featherfeet/6S092FinalProject/PhasedArrayReceiver/PDF_Plots/PhasedArrayReceiver-B_Cu.pdf

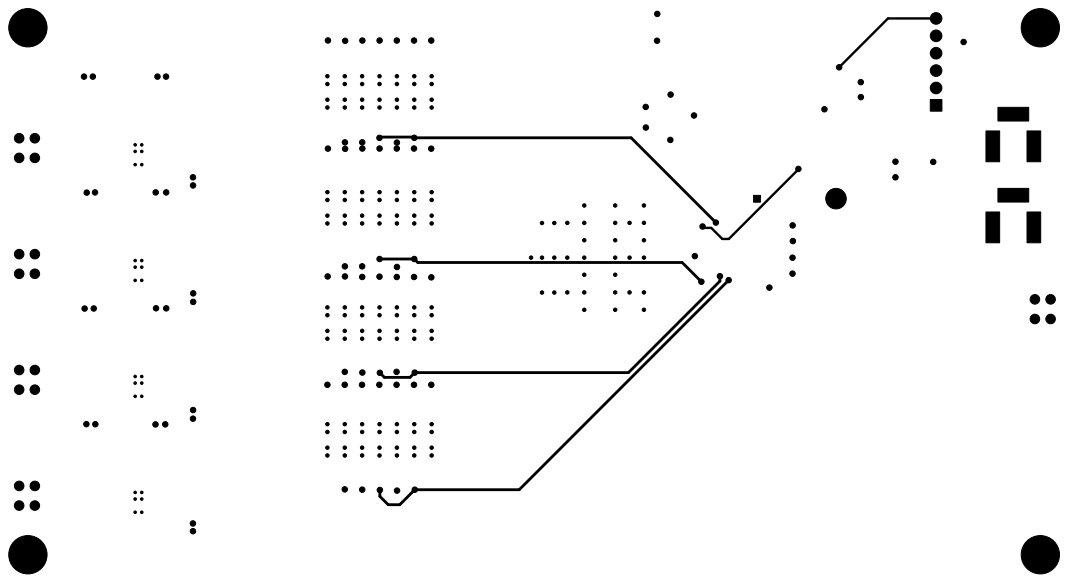
[picture p5: page 1]
