featherfeet/6S092FinalProject/PhasedArrayReceiver/PDF_Plots/PhasedArrayReceiver-B_Mask.pdf

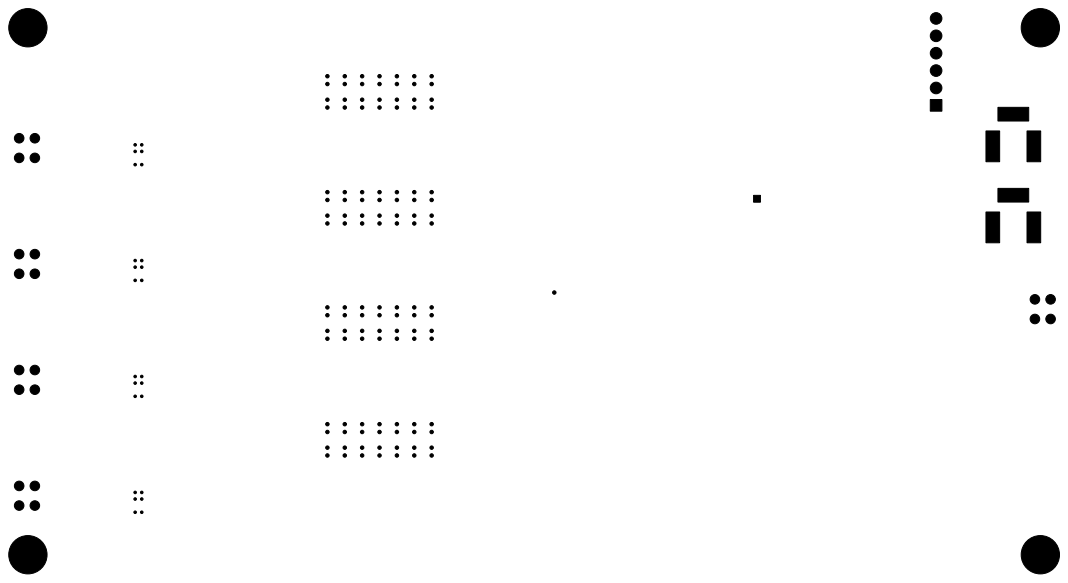
[picture p6: page 1]
