featherfeet/6S092FinalProject/PhasedArrayReceiver/PDF_Plots/PhasedArrayReceiver-Edge_Cuts.pdf

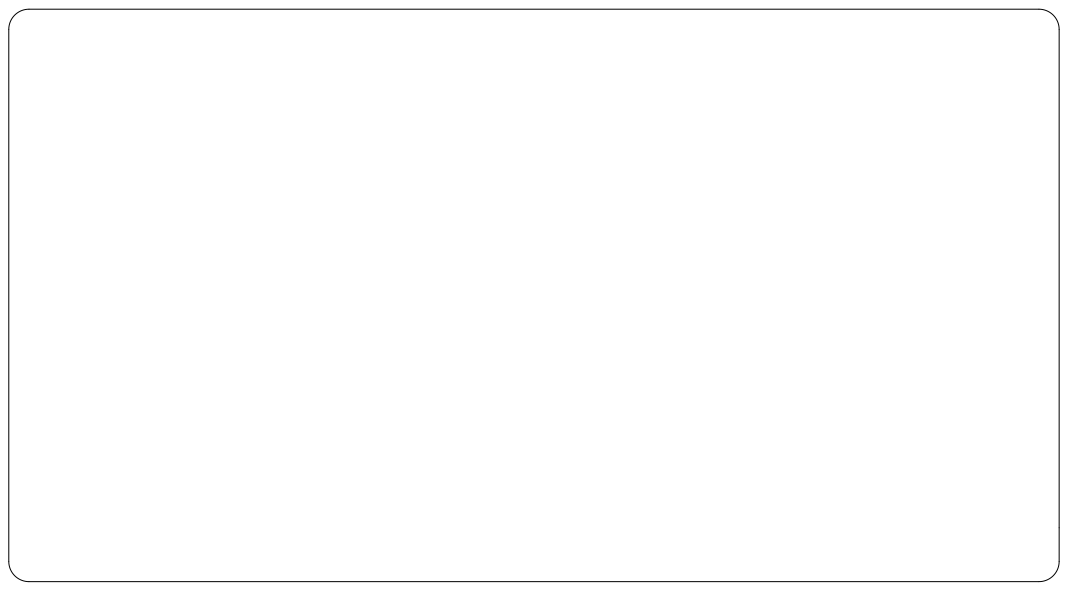
[picture p7: page 1]
