featherfeet/6S092FinalProject/PhasedArrayReceiver/PDF_Plots/PhasedArrayReceiver-F_Cu.pdf

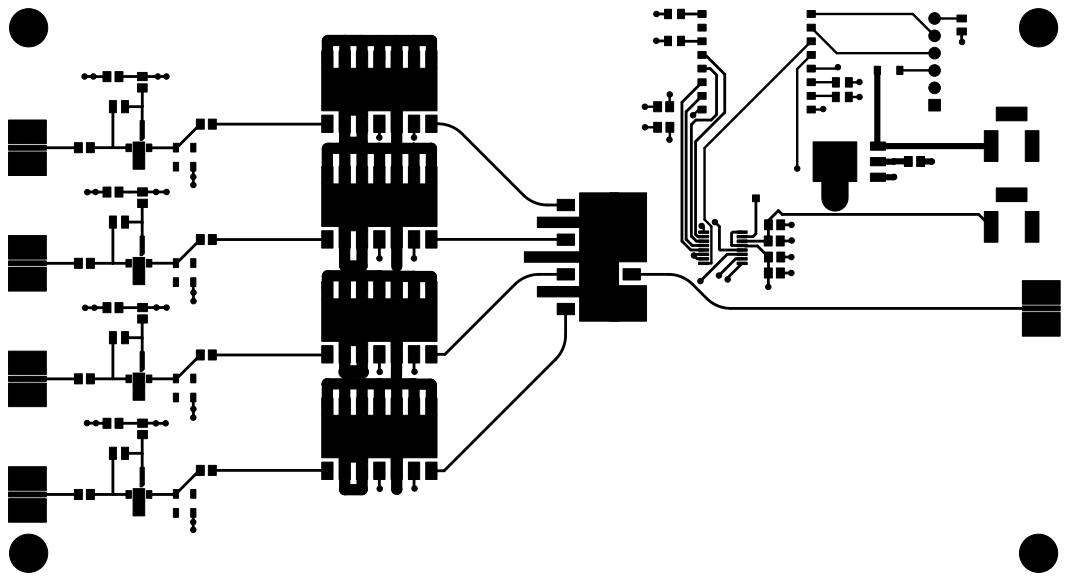
[picture p8: page 1]
