featherfeet/6S092FinalProject/PhasedArrayReceiver/PDF_Plots/PhasedArrayReceiver-F_Mask.pdf

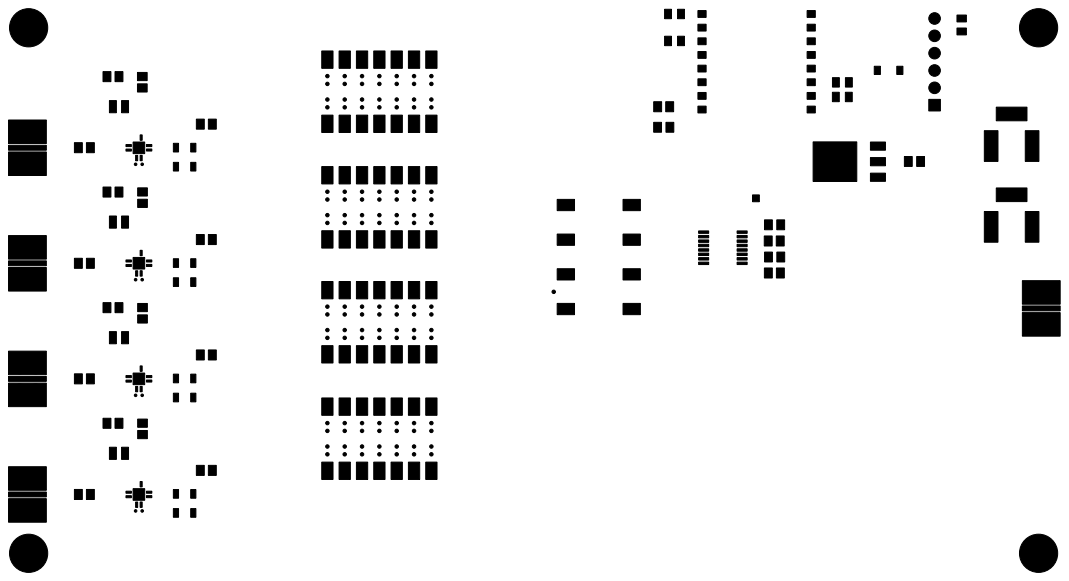
[picture p9: page 1]
