featherfeet/6S092FinalProject/PhasedArrayReceiver/PDF_Plots/PhasedArrayReceiver-F_Paste.pdf

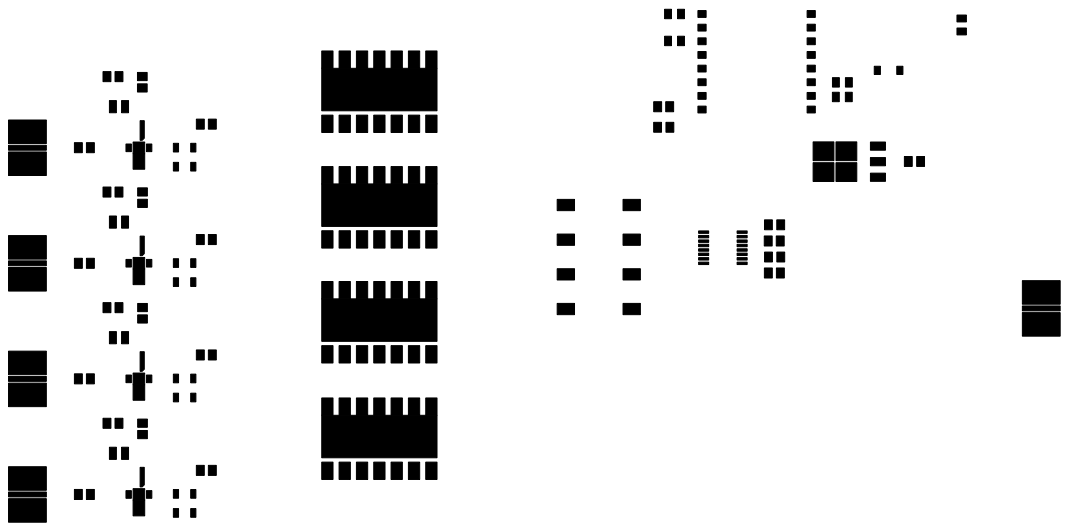
[picture p10: page 1]
