featherfeet/6S092FinalProject/PhasedArrayReceiver/PDF_Plots/PhasedArrayReceiver-F_Silkscreen.pdf

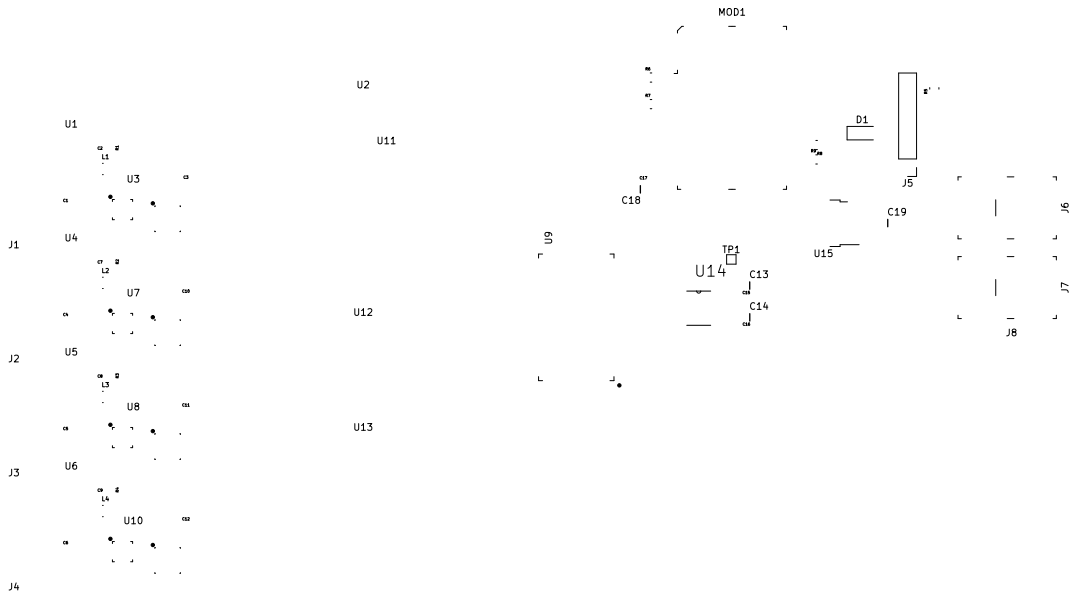
[picture p11: page 1]
