featherfeet/6S092FinalProject/PhasedArrayReceiver/PDF_Plots/PhasedArrayReceiver-In1_Cu.pdf

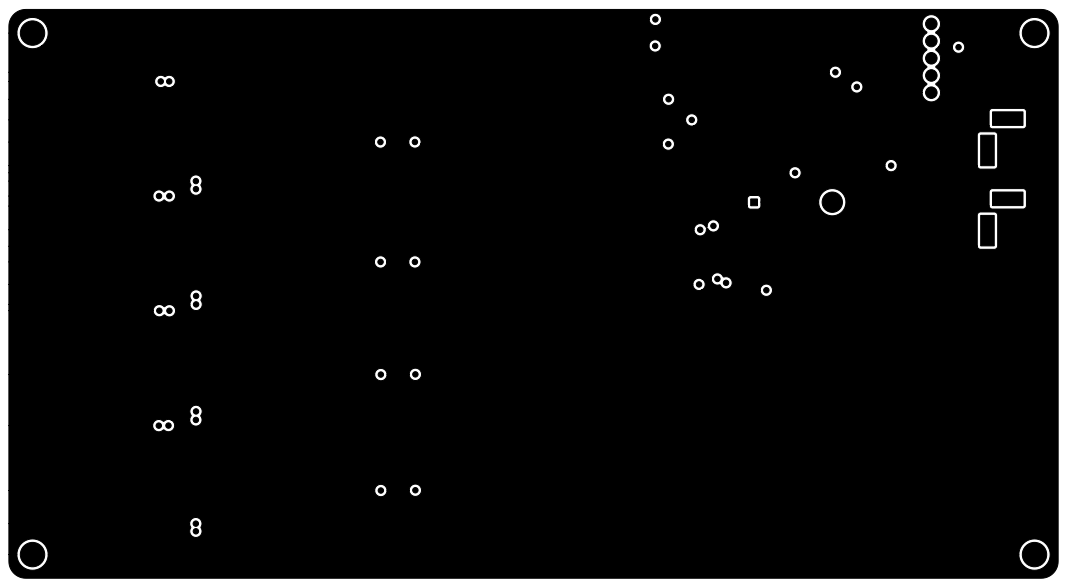
[picture p12: page 1]
