featherfeet/6S092FinalProject/PhasedArrayReceiver/PDF_Plots/PhasedArrayReceiver-In2_Cu.pdf

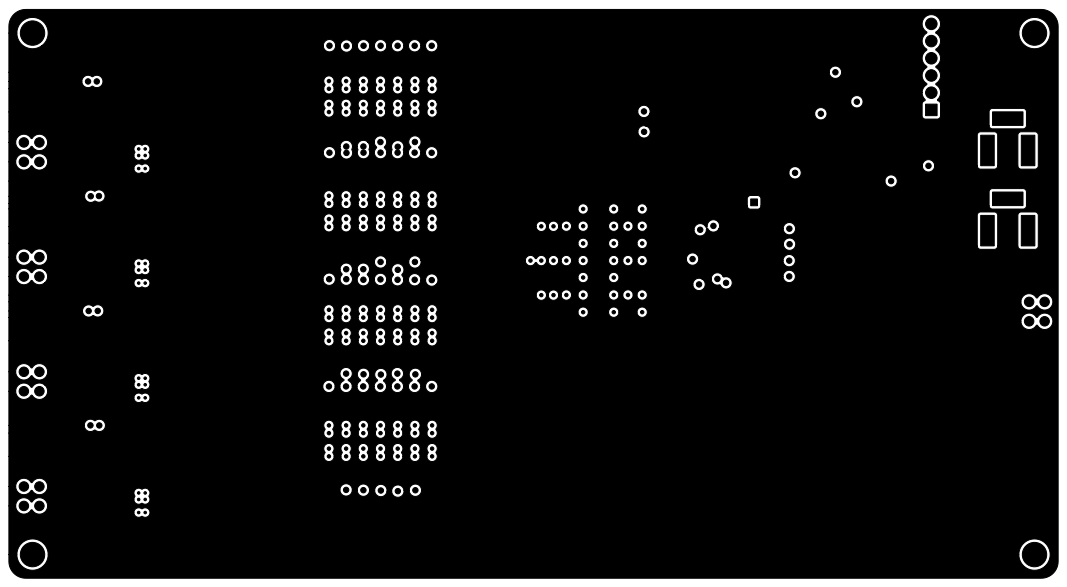
[picture p13: page 1]
