featherfeet/6S092FinalProject/PhasedArrayReceiver/PhasedArrayReceiver.kicad_pcb

## KiCad design PhasedArrayReceiver/PhasedArrayReceiver.kicad_pcb (2023-02-03)

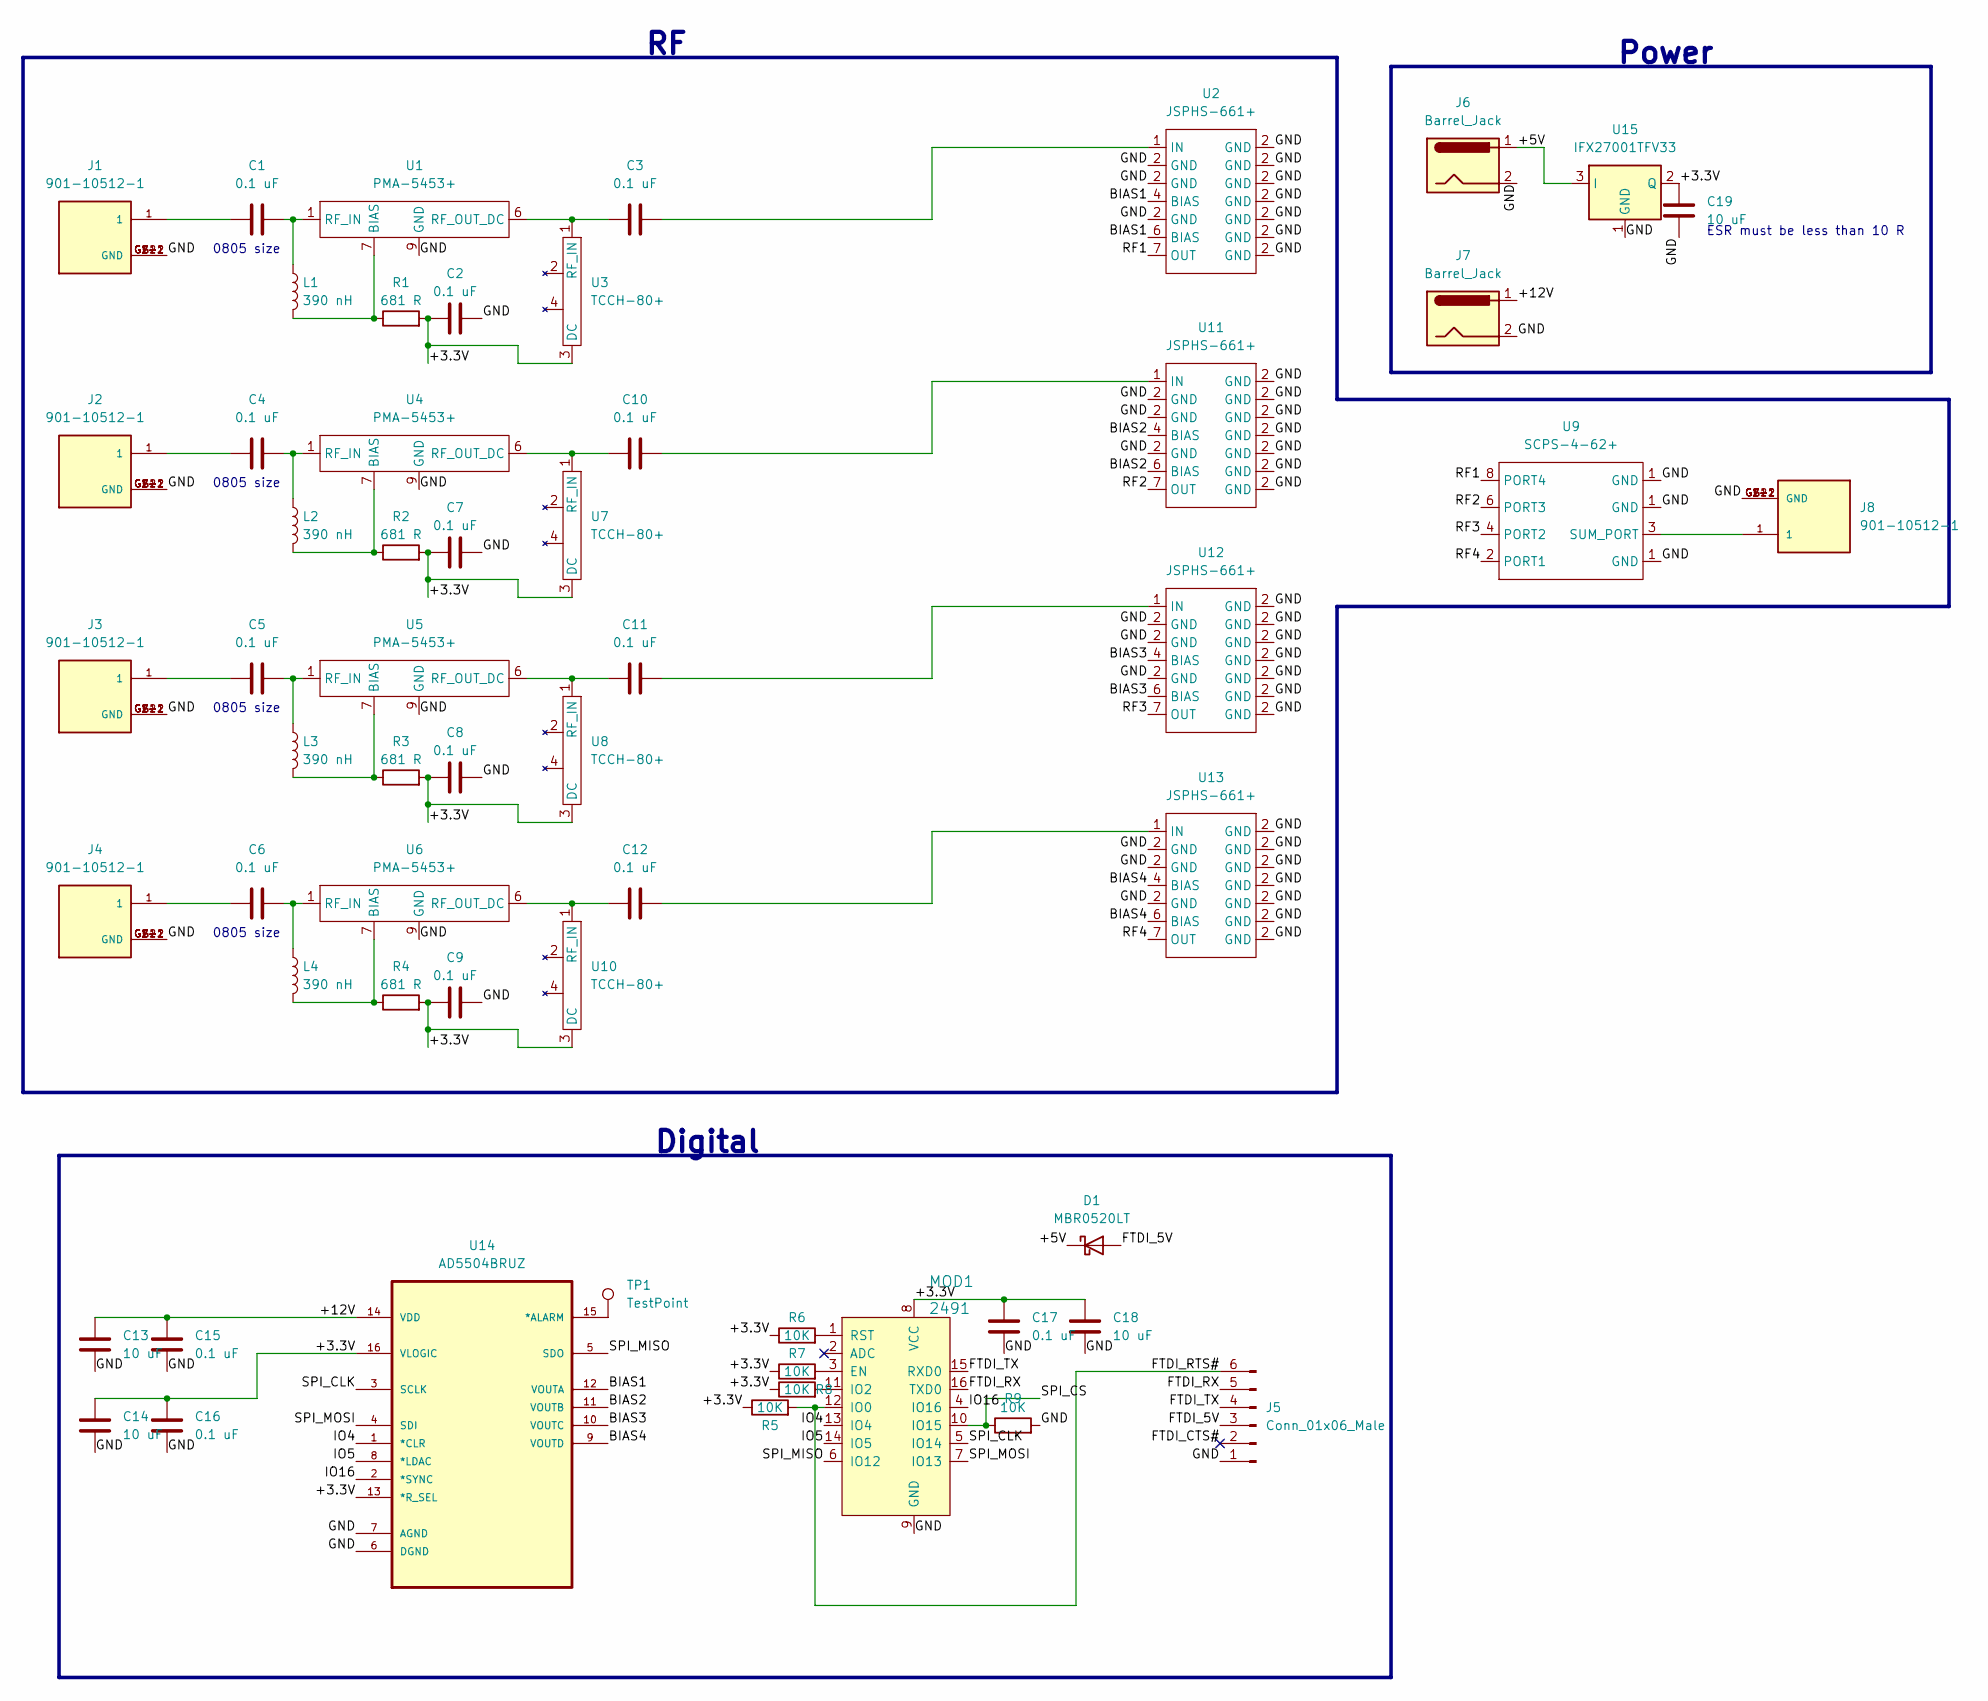
[picture p14: schematic PhasedArrayReceiver.kicad_sch]

Parts:
C1, C2, C3, C4, C5, C6, C7, C8, C9, C10, C11, C12, C15, C16, C17: 0.1 uF; CAPC2012X94N
C13, C14, C18, C19: 10 uF; CAPC2012X140N
D1: MBR0520LT; D_SOD-123
J1, J2, J3, J4, J8: 901-10512-1; AMPHENOL_901-10512-1; PARTREV A
J5: Conn_01x06_Male; PinHeader_1x06_P2.54mm_Vertical
J6, J7: Barrel_Jack; Barrel_Jack_5.5mmODx2.1mmID_PJ-202A
L1, L2, L3, L4: 390 nH; IND_AISC-0805-R39J-T
MOD1: 2491; WIFI_Module_ESP8266_2491; MPN 2491; Digi-Key_PN 1528-1438-ND
R1, R2, R3, R4: 681 R; RESC2012X60N
R5, R6, R7, R8, R9: 10K; RESC2012X65N
TP1: TestPoint; TestPoint_THTPad_1.0x1.0mm_Drill0.5mm
U1, U4, U5, U6: PMA-5453+
U2, U11, U12, U13: JSPHS-661+
U3, U7, U8, U10: TCCH-80+
U9: SCPS-4-62+
U14: AD5504BRUZ; SOP65P640X120-16N; MPN AD5504BRUZ
U15: IFX27001TFV33; TO-252-3_TabPin2

Connections:
/+3.3V: C2.1, C7.1, C8.1, C9.1, C14.1, C16.1, C17.1, C18.1, C19.1, MOD1.8 (VCC), R1.2, R2.2, R3.2, R4.2, R5.1, R6.1, R7.1, R8.1, U3.3 (DC), U7.3 (DC), U8.3 (DC), U10.3 (DC), U14.13 (*R_SEL), U14.16 (VLOGIC), U15.2 (Q)
/+5V: D1.1 (K), J6.1, U15.3 (I)
/+12V: C13.1, C15.1, J7.1, U14.14 (VDD)
/BIAS1: U2.4 (BIAS), U2.6 (BIAS), U14.12 (VOUTA)
/BIAS2: U11.4 (BIAS), U11.6 (BIAS), U14.11 (VOUTB)
/BIAS3: U12.4 (BIAS), U12.6 (BIAS), U14.10 (VOUTC)
/BIAS4: U13.4 (BIAS), U13.6 (BIAS), U14.9 (VOUTD)
/FTDI_5V: D1.2 (A), J5.3
/FTDI_CTS#: J5.2
/FTDI_RTS#: J5.6, MOD1.12 (IO0), R5.2
/FTDI_RX: J5.5, MOD1.16 (TXD0)
/FTDI_TX: J5.4, MOD1.15 (RXD0)
/GND: C2.2, C7.2, C8.2, C9.2, C13.2, C14.2, C15.2, C16.2, C17.2, C18.2, C19.2, J1.G1 (GND), J1.G1-1 (GND), J1.G1-2 (GND), J1.G2 (GND), J1.G2-1 (GND), J1.G2-2 (GND), J2.G1 (GND), J2.G1-1 (GND), J2.G1-2 (GND), J2.G2 (GND), J2.G2-1 (GND), J2.G2-2 (GND), J3.G1 (GND), J3.G1-1 (GND), J3.G1-2 (GND), J3.G2 (GND), J3.G2-1 (GND), J3.G2-2 (GND), J4.G1 (GND), J4.G1-1 (GND), J4.G1-2 (GND), J4.G2 (GND), J4.G2-1 (GND), J4.G2-2 (GND), J5.1, J6.2, J7.2, J8.G1 (GND), J8.G1-1 (GND), J8.G1-2 (GND), J8.G2 (GND), J8.G2-1 (GND), J8.G2-2 (GND), MOD1.9 (GND), R9.2, U1.9 (GND), U2.2 (GND), U4.9 (GND), U5.9 (GND), U6.9 (GND), U9.1 (GND), U11.2 (GND), U12.2 (GND), U13.2 (GND), U14.6 (DGND), U14.7 (AGND), U15.1 (GND)
/IO4: MOD1.13 (IO4), U14.1 (*CLR)
/IO5: MOD1.14 (IO5), U14.8 (*LDAC)
/IO16: MOD1.4 (IO16), U14.2 (*SYNC)
/RF1: U2.7 (OUT), U9.8 (PORT4)
/RF2: U9.6 (PORT3), U11.7 (OUT)
/RF3: U9.4 (PORT2), U12.7 (OUT)
/RF4: U9.2 (PORT1), U13.7 (OUT)
/SPI_CLK: MOD1.5 (IO14), U14.3 (SCLK)
/SPI_CS: MOD1.10 (IO15), R9.1
/SPI_MISO: MOD1.6 (IO12), U14.5 (SDO)
/SPI_MOSI: MOD1.7 (IO13), U14.4 (SDI)
unnamed: C1.1, J1.1
unnamed: C1.2, L1.1, U1.1 (RF_IN)
unnamed: C3.1, U1.6 (RF_OUT_DC), U3.1 (RF_IN)
unnamed: C3.2, U2.1 (IN)
unnamed: C4.1, J2.1
unnamed: C4.2, L2.1, U4.1 (RF_IN)
unnamed: C5.1, J3.1
unnamed: C5.2, L3.1, U5.1 (RF_IN)
unnamed: C6.1, J4.1
unnamed: C6.2, L4.1, U6.1 (RF_IN)
unnamed: C10.1, U4.6 (RF_OUT_DC), U7.1 (RF_IN)
unnamed: C10.2, U11.1 (IN)
unnamed: C11.1, U5.6 (RF_OUT_DC), U8.1 (RF_IN)
unnamed: C11.2, U12.1 (IN)
unnamed: C12.1, U6.6 (RF_OUT_DC), U10.1 (RF_IN)
unnamed: C12.2, U13.1 (IN)
unnamed: J8.1, U9.3 (SUM_PORT)
unnamed: L1.2, R1.1, U1.7 (BIAS)
unnamed: L2.2, R2.1, U4.7 (BIAS)
unnamed: L3.2, R3.1, U5.7 (BIAS)
unnamed: L4.2, R4.1, U6.7 (BIAS)
unnamed: MOD1.1 (RST), R6.2
unnamed: MOD1.3 (EN), R7.2
unnamed: MOD1.11 (IO2), R8.2
unnamed: TP1.1, U14.15 (*ALARM)

Notes on the sheet:
0805 size
ESR must be less than 10 R
Power
Digital

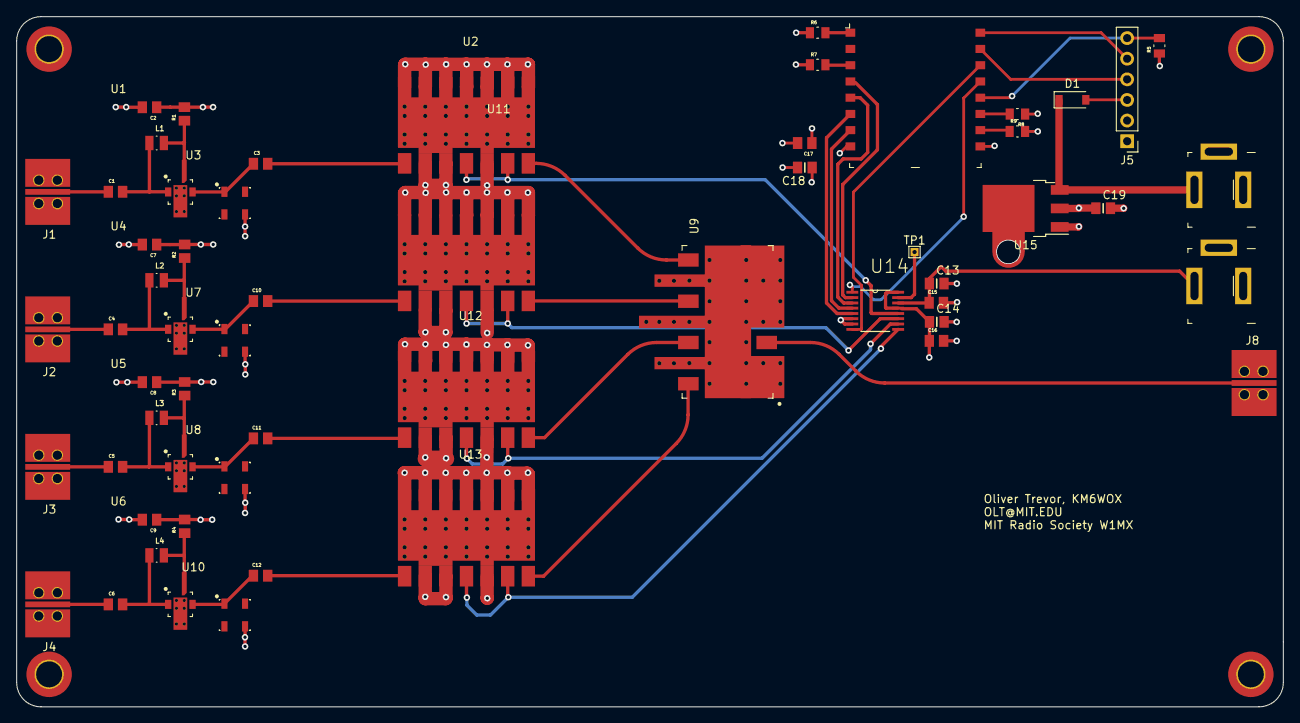
[picture p15: board PhasedArrayReceiver.kicad_pcb from above]

Board: 4 copper layers, 156.0 x 85.0 mm, 58 parts (0 on the bottom side), 48 nets.
